FatemaJanahi/Trooper-Chase/README.md

# Trooper-Chase
Whack-a-mole style Star Wars themed game for a client, programmed using Arduino.
